xzhang03/Encoder_USB/README.md

# Encoder_USB
 USB-based quad encoder

Two equavalent versions that use Adafruit Trinket M0 and Seeeduino Xiao respectively. Seeeduino Xiao RP2040 would also work.

Uploading tip: The M0 processer that both boards use sometimes needs to be forced into bootloading mode before Arduino IDE can upload the binaries. To do so in Trinket M0, double tap the reset button after plugging the USB. To do so in Seeeduino Xiao, use a wire to short the two reset pins twice (mimicking a double button push) next to the USB-C socket after plugging in the USB. These steps archieve the same purpose.

Current limiting resistor (R1) range: at least 150-350 Ohm if not wider.

Other materials:
1. Trinket M0 or Seeduino Xiao (https://www.digikey.com/en/products/detail/adafruit-industries-llc/3500/7623049 or https://www.seeedstudio.com/Seeeduino-XIAO-Arduino-Microcontroller-SAMD21-Cortex-M0+-p-4426.html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)
2. Beam breakers (https://www.digikey.com/en/products/detail/sharp-socle-technology/GP1A57HRJ00F/718287)
3. Resistor (any 330 Ohm through-hole resistor will do)

Trinket M0 (most common for NLW scope): https://learn.adafruit.com/adafruit-trinket-m0-circuitpython-arduino/pinouts

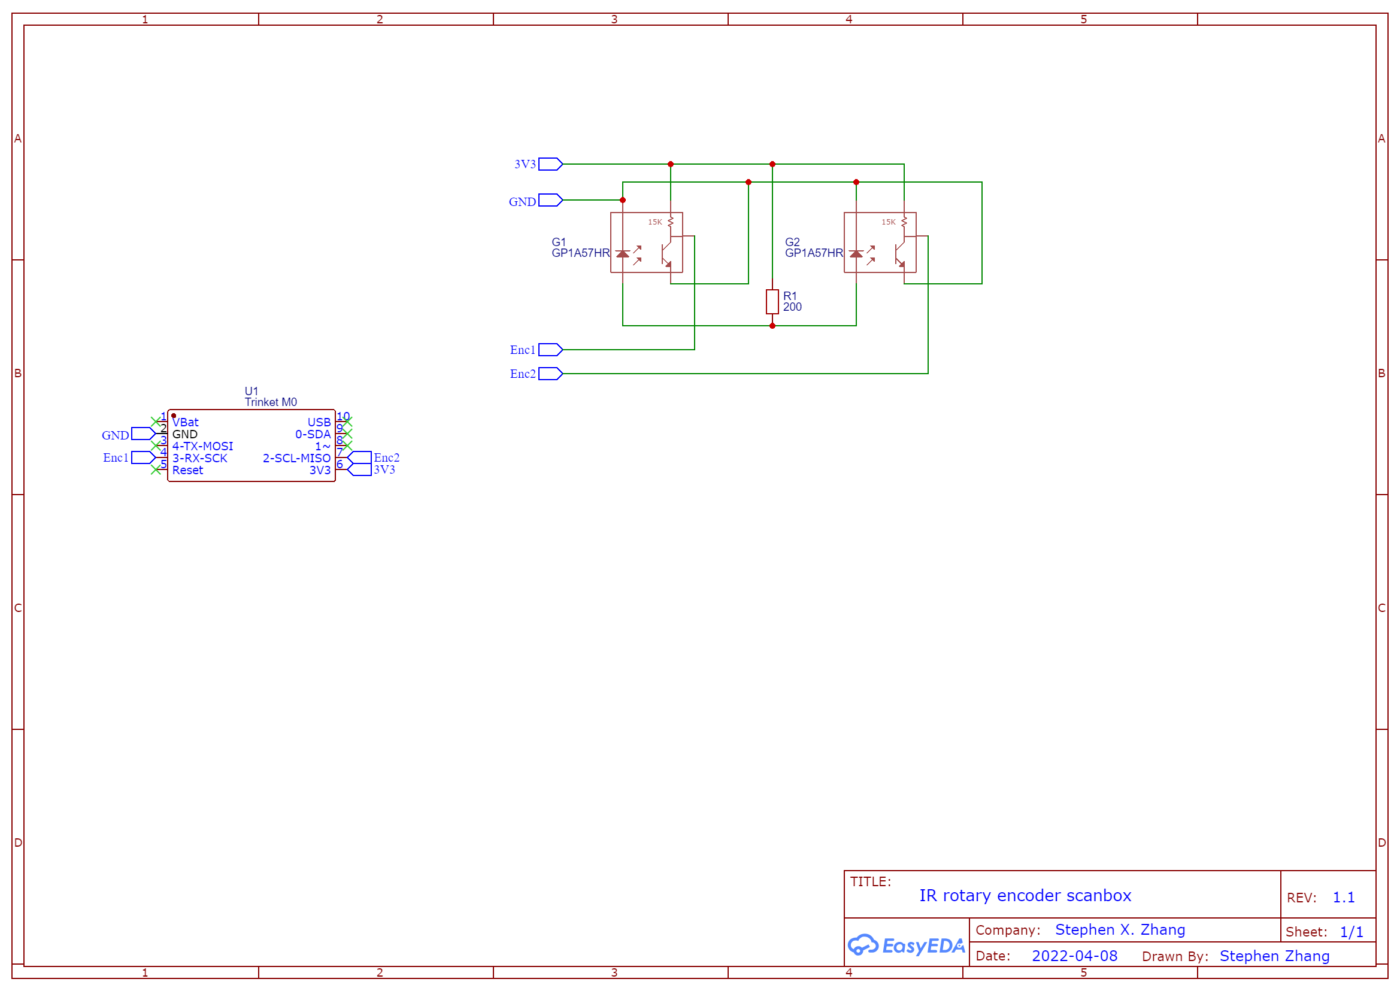
[picture p1: Trinket variant/Schematic_IR rotary encoder trinket v1_2022-12-29.png]
Schematic


Seeeduino Xiao (suitable for NLW scope): https://wiki.seeedstudio.com/Seeeduino-XIAO/

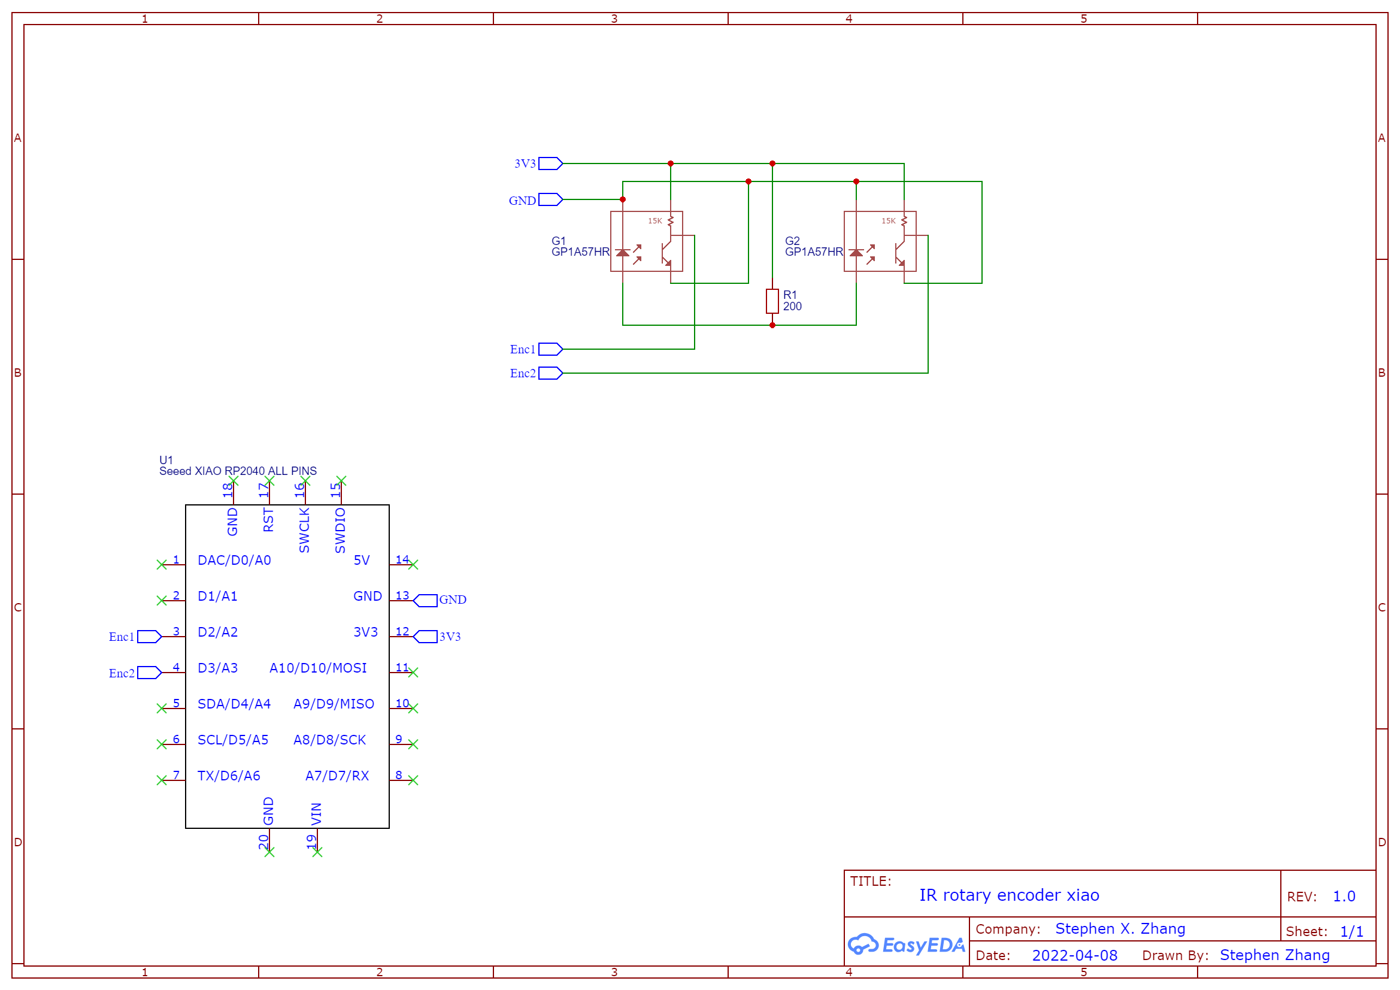
[picture p2: Xiao variant/Schematic_IR rotary encoder xiao v1_2022-12-18.png]
Schematic


Trinket M0 for Bruker scope:

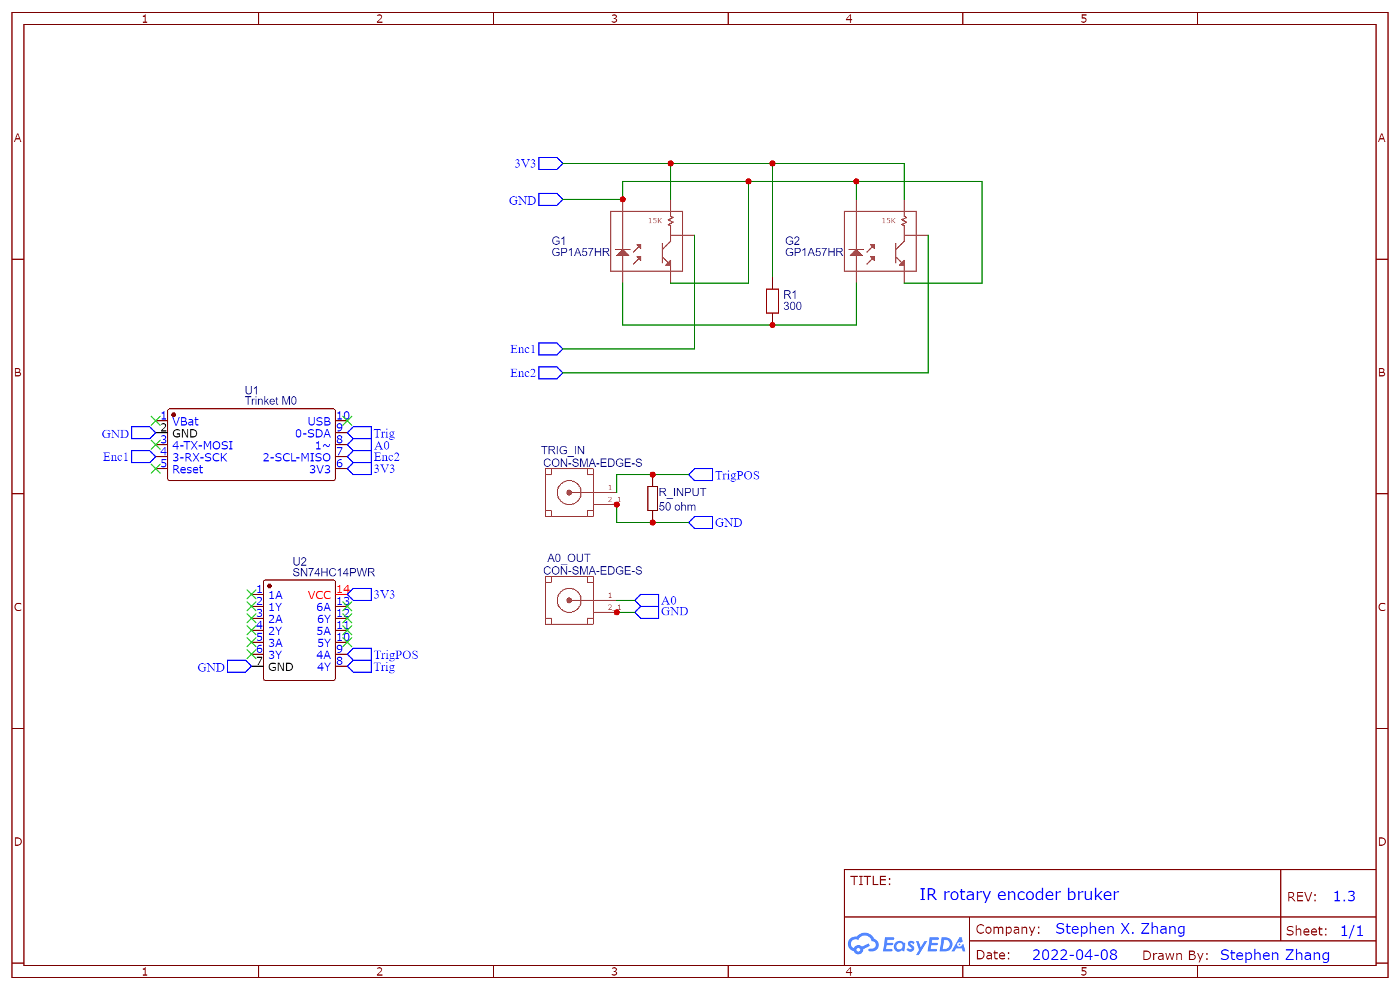
[picture p3: Encoder bruker/PCB/Schematic_IR rotary encoder bruker trinket_2024-11-13.png]
Schematic
