xzhang03/Encoder_USB/Trinket variant/Schematic_IR rotary encoder trinket v1_2022-12-27.pdf

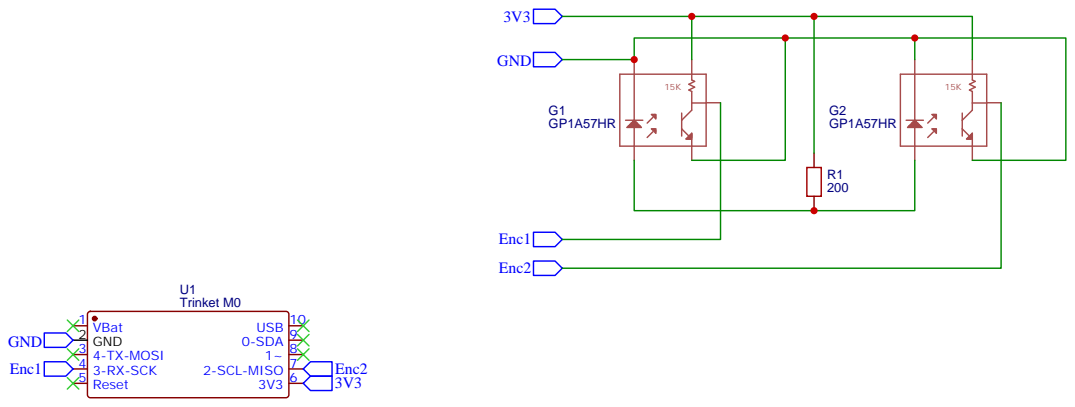
[picture p5: page 1]

Drawn By: Stephen Zhang
