xzhang03/Encoder_USB/(list of files, drawings)

Other design files:
Encoder bruker/PCB/PCB_PCB_IR rotary encoder v1 trinket copy_2024-11-13.json
Encoder bruker/PCB/SCH_IR rotary encoder bruker trinket_2024-11-13.json
Encoder bruker/SCH_IR-rotary-encoder-bruker-trinket_2024-10-31.json
Trinket variant/PCB_PCB_IR rotary encoder v1 trinket_2022-12-27.json
Trinket variant/SCH_IR rotary encoder trinket v1_2022-12-27.json
Xiao variant/PCB_PCB_IR rotary encoder v1 xiao_2022-12-18.json
Xiao variant/SCH_IR rotary encoder xiao v1_2022-12-18.json
