xzhang03/Encoder_USB/Encoder bruker/Quad_encoder_trinketm0_bruker/Quad_encoder_trinketm0_bruker.ino

// Make sure encoder library is 1.4.3 or later
#define debug false
#define debugstream false

// Turn off neopixel
#include <Adafruit_DotStar.h>
#include <SPI.h>
#define NUMPIXELS 1 // Number of LEDs in strip
#define DATAPIN 7
#define CLOCKPIN 8
Adafruit_DotStar strip = Adafruit_DotStar(
  NUMPIXELS, DATAPIN, CLOCKPIN, DOTSTAR_BGR);

#include <Encoder.h>
Encoder myEnc(2, 3); // Switch order to alter direction

// Pins
const byte ledpin = 13;
const byte trigpin = 0;

// Analog out cycle cycle
unsigned long tcycle = 6000; // us, how often analog writes are sent
unsigned long twidth = 4000; // us, how long each analog write is

// Analog voltages (10 bit dac)
// Range: 4 steps forward or backward per cycle. Most of time it should be 1 step, so vsteps are largest in these situations
// indices     =     { 0,   1,   2,   3,   4,   5,   6,   7,    8}
// Pos         =     {-1,  -2,  -3,  -4,   0,   4,   3,   2,    1}
uint16_t vsteps[9] = { 0, 127, 255, 383, 511, 639, 764, 895, 1023};
int8_t vind;
uint8_t max_step = 4;

// Encoder
long pos, pos2;
long debug_pos, debug_pos0;

// time variables
unsigned long tnow, t0;

// Bool variables
bool led = false;
bool stepdone = false;

// Serial 
byte m, n;
bool debugflag1;

void setup() {
  Serial.begin(115200);
  myEnc.write(0);

  // Turn off dot star
  strip.begin(); // Initialize pins for output
  strip.setPixelColor(0, 0x000000); // black
  strip.show();  // Turn all LEDs off ASAP

  pinMode(ledpin, OUTPUT);
  pinMode(trigpin, INPUT); // Reserved for the future
  digitalWrite(ledpin, led);

  // Timers
  tnow = micros();
  t0 = micros();

  #if debugstream
    debug_pos = 0;
    debug_pos0 = 0;
  #endif
}

void loop() {
  // Time
  tnow = micros();

  // New cycle
  if (((tnow - t0) > tcycle) && !stepdone){
    // Update time
    t0 = tnow;

    // Read
    pos = myEnc.read();


    // Decide what to write
    // V index
    if ((pos > -4) && (pos < 4)){
      // Make sure the quad signals are super-threshold (+/-4)
      // No step
      pos2 = 0;
      vind = 4;

      // Update LED to off
      led = false;
    }
    else if (pos > 4){
      
      // Forward
      pos2 = pos / 4;

      if (pos2 > 4){
        pos2 = 4;
      }
      
      // Ind
      vind = 9 - pos2;
      
      // LED indicator on
      led = true;
      myEnc.write(pos - pos2 * 4);

      // Debug stream
      // Serial debug
      #if debugstream
        debug_pos = debug_pos + pos2;
        if ((debug_pos - debug_pos0) != 0){
          Serial.print(pos);
          Serial.print(" ");
          Serial.print(pos2);
          Serial.print(" ");
          Serial.println(debug_pos);
          debug_pos0 = debug_pos;
        }
      #endif
    }
    else if (pos <= -4){
      
      // Backward
      pos2 = pos / 4;
      
      // Cap speed
      if (pos2 <= -4){
        pos2 = -4;
      }
      
      // Ind
      vind = -(pos2 + 1);

      // LED indicator on
      led = true;
      myEnc.write(pos - pos2 * 4);

      // Debug stream
      // Serial debug
      #if debugstream
        debug_pos = debug_pos + pos2;
        if ((debug_pos - debug_pos0) != 0){
          Serial.print(pos);
          Serial.print(" ");
          Serial.print(pos2);
          Serial.print(" ");
          Serial.println(debug_pos);
          debug_pos0 = debug_pos;
        }
      #endif
    }

    // Write
    analogWrite(A0, vsteps[vind]);

    // Update
    stepdone = true;
    
    // led
    digitalWrite(ledpin, led);
    
    // Debug 
    #if debug
      if (Serial.available() > 1) {
        // Read
        m = Serial.read();
        n = Serial.read();
        m = m - '0';

        // Manually input pos for testing
        if ((m > 0) && (m < 10)){
          // m   =  1,  2,  3,  4, 5, 6, 7, 8, 9
          // pos = -4, -3, -2, -1, 0, 1, 2, 3, 4
          pos = m - 5;
        }

        Serial.print(m);
        Serial.print(" ");
        Serial.print(n);
        Serial.print(": ");
        Serial.print(pos);

        Serial.print(" ");
        Serial.print(vind);
        Serial.print(" ");
        Serial.println(vsteps[vind]);
      }
    #endif

    

  }
  else if (((tnow - t0) > twidth) && stepdone){
    // Turn off the step
    analogWrite(A0, vsteps[4]);
    stepdone = false;
  }
}
