xzhang03/Encoder_USB/Xiao variant/Quad_encoder_xiao/Quad_encoder_xiao.ino

// Make sure encoder library is 1.4.3 or later

#define debug false

#include <Encoder.h>
Encoder myEnc(2, 3);

const byte ledpin = 13;
bool led = false;

void setup() {
  Serial.begin(115200);
//  Serial1.begin(1000000);
  myEnc.write(0);

  pinMode(ledpin, OUTPUT);
  digitalWrite(ledpin, led);
}

void loop() {
  long pos;
  byte *b,m;

  b = (byte *) &pos;  
  pos = myEnc.read();

  if (Serial.available()) {
    m = Serial.read();

    // Adjust for arduino serial encoding
    #if debug
      m = m - '0';
    #endif

    #if !debug 
      // Normal version
      if(m>0) {
        myEnc.write(0);    // zero the position
        pos = 0;
      }
      else {
        Serial.write((byte *) &pos,4);
      }
    #else
      // Debug version
      Serial.print(m);
      Serial.print(" ");
      Serial.println(pos);
    #endif 

    // toggle led
    led = !led;
    digitalWrite(ledpin, led);
  }

//  if(Serial1.available()) {
//    Serial1.read();
//    Serial1.write((byte *) & pos,4);
//  }
  
}
