xzhang03/Encoder_USB/(commit log)

2022-12-30 update schematic
2024-11-12 added analog encoder
    [PCB_PCB_IR-rotary-encoder-v1-trinket-copy_2024-10-31.json, SCH_IR-rotary-encoder-bruker-trinket_2024-10-31.json]
2024-11-13 updated design and readme
    [PCB_PCB_IR rotary encoder v1 trinket copy_2024-11-13.json, PCB_PCB_IR-rotary-encoder-v1-trinket-copy_2024-10-31.json, SCH_IR rotary encoder bruker trinket_2024-11-13.json]
